loopmasta/shieldXL-case/cad/shieldXL_case.step

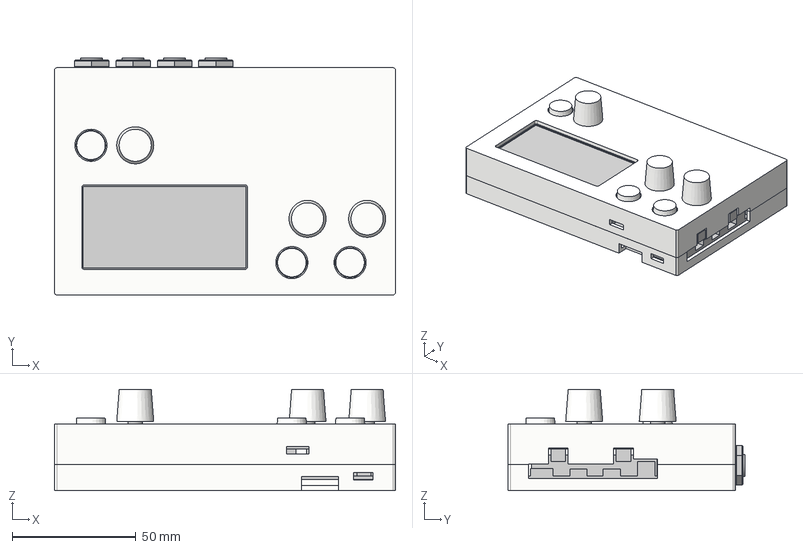
[picture p4: CAD file, 2026-11-01]
cad/shieldXL_case.step
138.0 x 95.9 x 40.9 mm
Case
RPi4_placeholder
ShieldXL_placeholder
OLED_placeholder
Audio_Nut x 4
6mm D-shaft knob x 3
Kailh_choc_button x 3
