loopmasta/shieldXL-case/exports/shieldXL_case_Knob.3mf

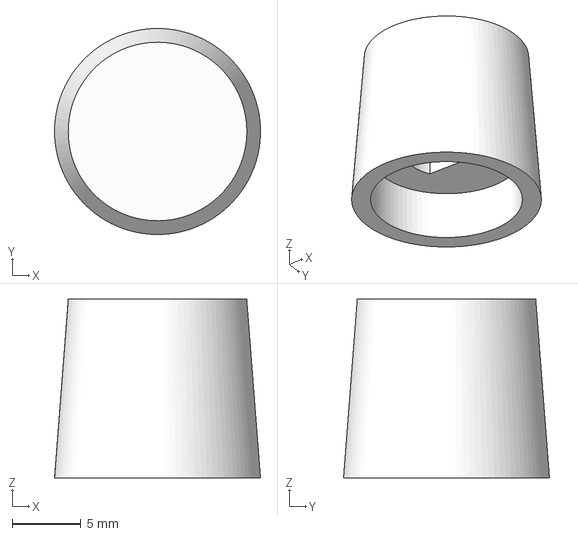
[picture p5: CAD file, 2026-11-01]
exports/shieldXL_case_Knob.3mf
15.0 x 15.0 x 13.0 mm
