loopmasta/shieldXL-case/exports/shieldXL_case_Button_Cap.3mf

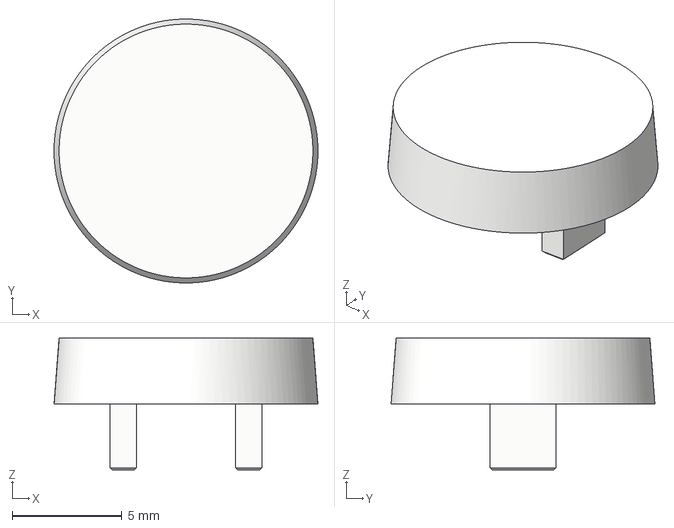
[picture p6: CAD file, 2026-11-01]
exports/shieldXL_case_Button_Cap.3mf
12.0 x 12.0 x 6.00 mm
