loopmasta/shieldXL-case/exports/shieldXL_case_Bottom.3mf

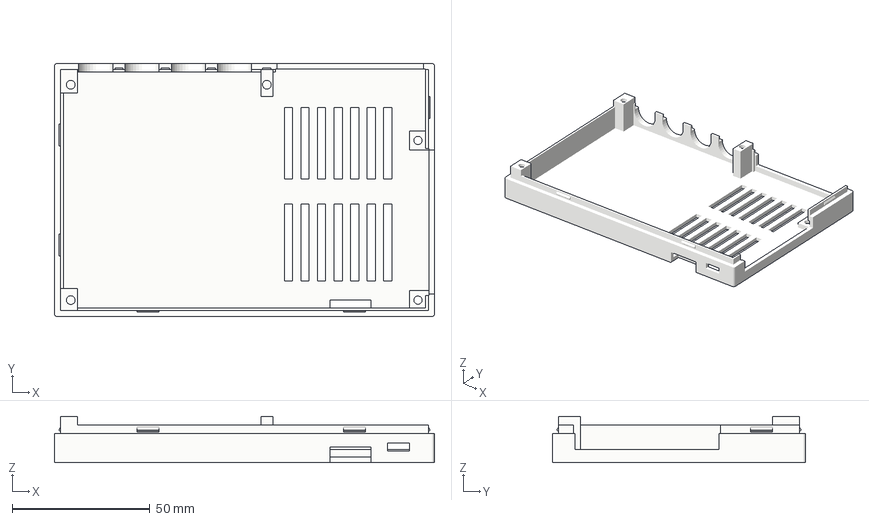
[picture p7: CAD file, 2026-11-01]
exports/shieldXL_case_Bottom.3mf
138.0 x 92.0 x 16.8 mm
