loopmasta/shieldXL-case/exports/shieldXL_case_Audio_Nut.3mf

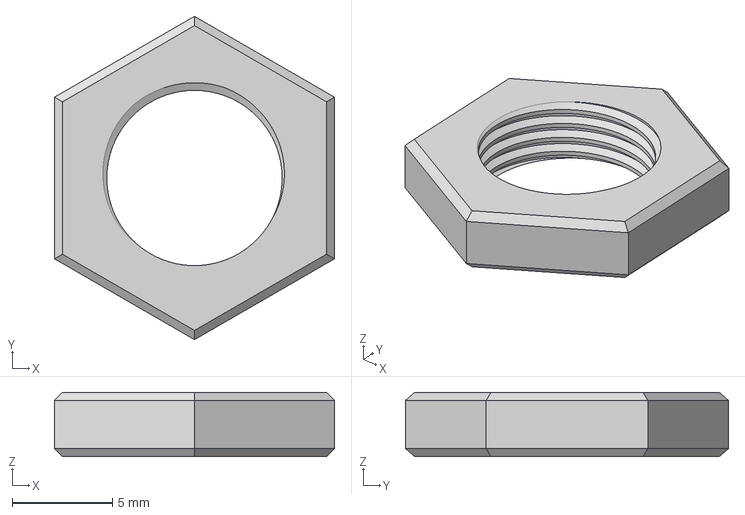
[picture p9: CAD file, 2026-11-01]
exports/shieldXL_case_Audio_Nut.3mf
14.0 x 16.2 x 3.20 mm
