loopmasta/shieldXL-case/(commit log)

2026-11-01 Initial release: shieldXL snap-fit case
    Two-part 3D-printable case for the shieldXL (Raspberry Pi 4 norns shield)
    with knobs, button caps and audio jack nuts. Printable 3MF files, a STEP
    export of the Fusion design, README and GPL v3 license.
    [shieldXL_case.step, shieldXL_case_Audio_Nut.3mf, shieldXL_case_Bottom.3mf, shieldXL_case_Button_Cap.3mf, shieldXL_case_Knob.3mf, shieldXL_case_Top.3mf]
2026-11-01 README: photos of the test print, drop the prototype note
2026-11-01 Left button: hole and cap 0.5 mm toward the back (y 14.59 mm), re-export all
    [shieldXL_case.step, shieldXL_case_Audio_Nut.3mf, shieldXL_case_Bottom.3mf, shieldXL_case_Button_Cap.3mf, shieldXL_case_Knob.3mf, shieldXL_case_Top.3mf]
2026-11-01 Pi standoffs: square blocks touching the walls, clear of the Pi LED window; old round bosses removed
    [shieldXL_case.step, shieldXL_case_Audio_Nut.3mf, shieldXL_case_Bottom.3mf, shieldXL_case_Button_Cap.3mf, shieldXL_case_Knob.3mf, shieldXL_case_Top.3mf]
